ShadowFox88/keyboard/README.md

# Keyboard

This is a repo with the files used to make my own mechanical keyboard.

Why? It seemed like a fun project to do.

A journal of the time spent is available at report/report.pdf.

I used KiCad, and Fusion360 for this, and had to learn both of them.
All images are in the report.
