ShadowFox88/keyboard/images/keys.png

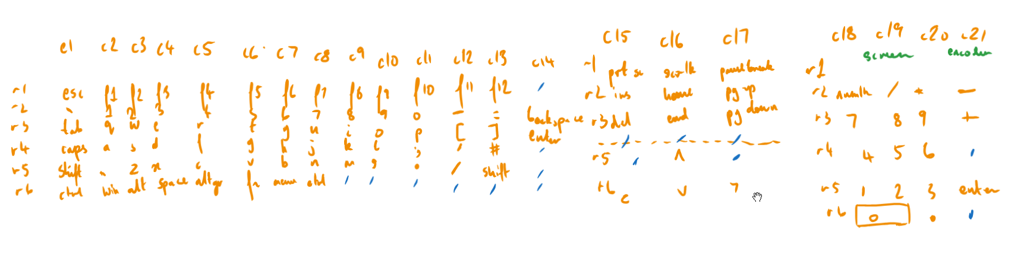
images/keys.png
