ShadowFox88/keyboard/images/keys_schematic.png

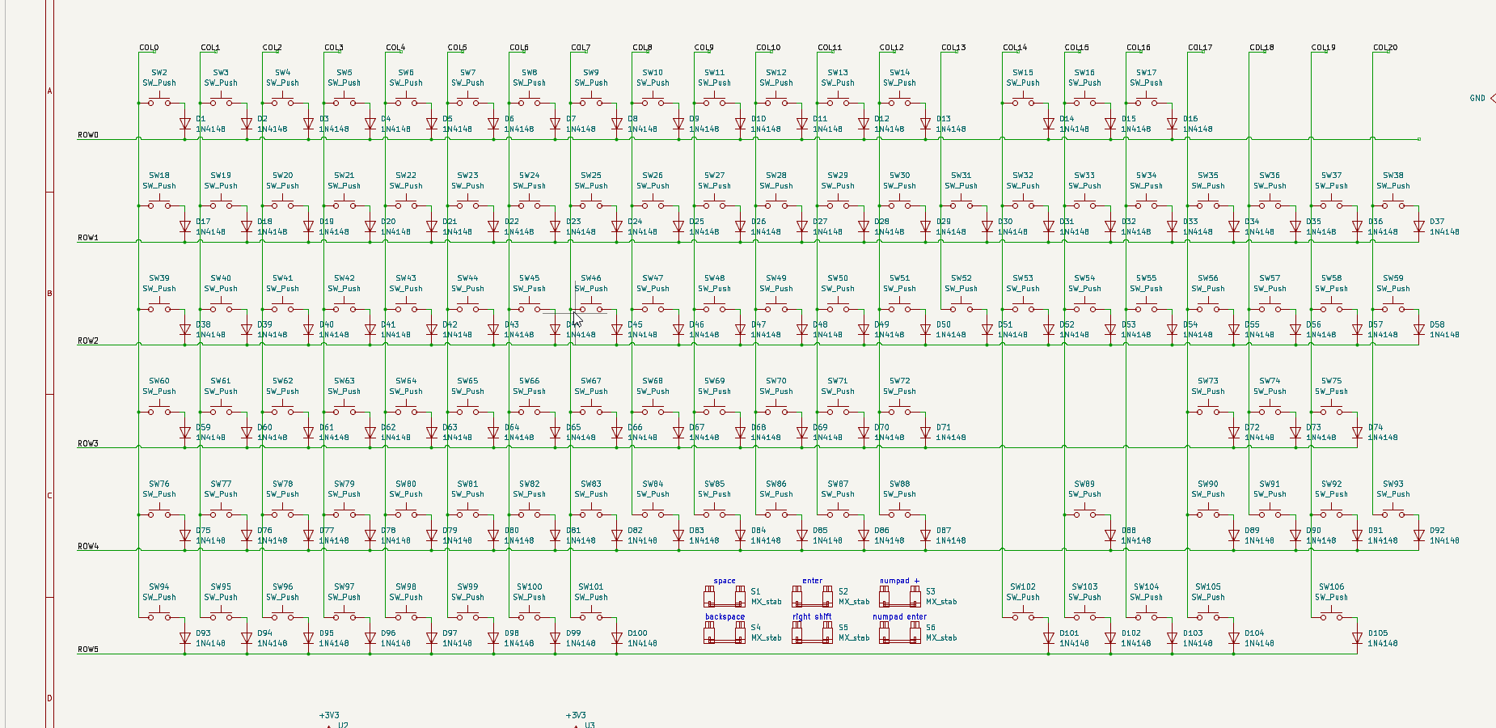
images/keys_schematic.png
