ShadowFox88/keyboard/images/pcb.png

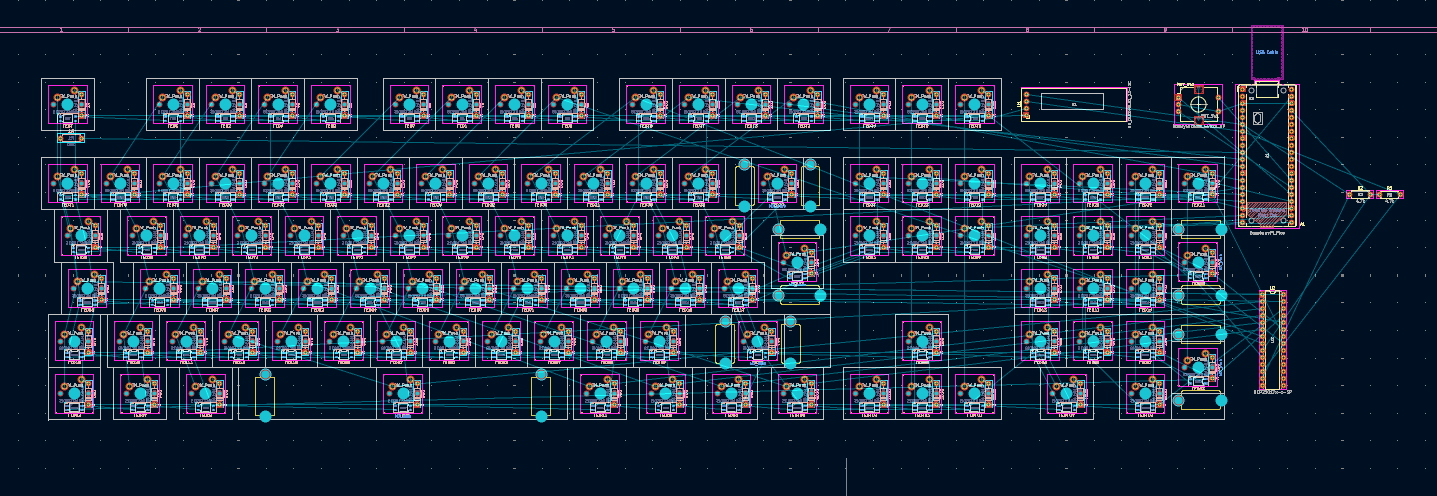
images/pcb.png
