ShadowFox88/keyboard/images/pcb_routing.png

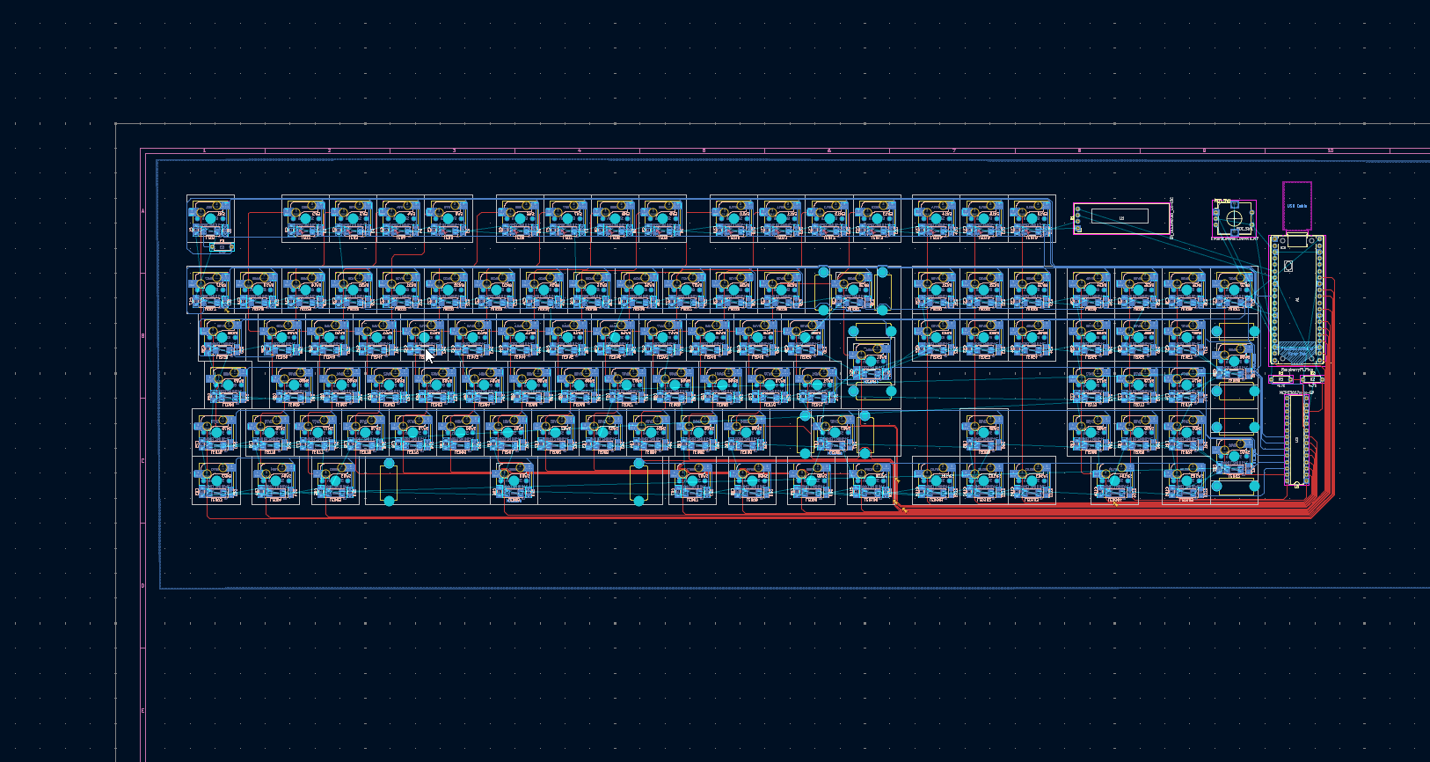
images/pcb_routing.png
