ShadowFox88/keyboard/images/rotary_and_screen.png

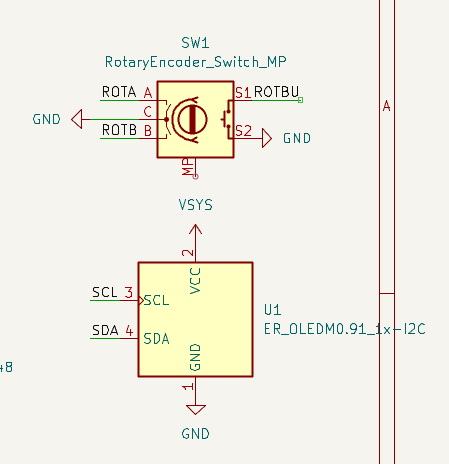
images/rotary_and_screen.png
