ShadowFox88/keyboard/pcb/pcb_v2.step

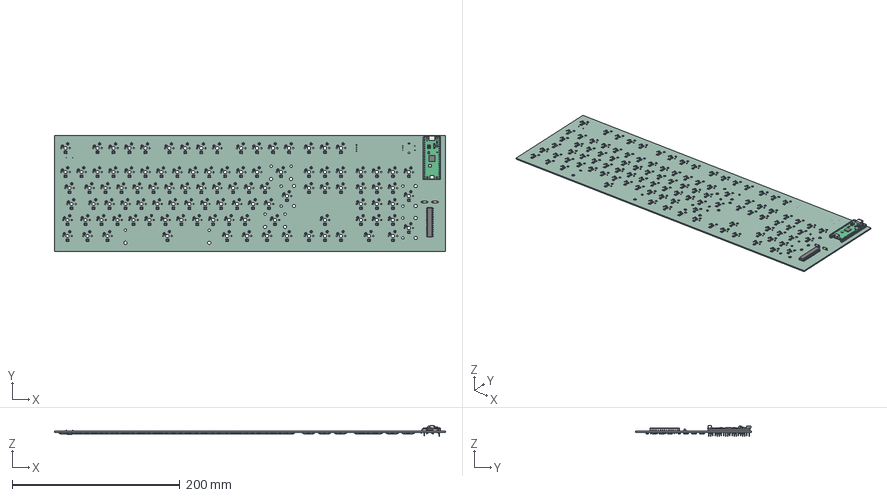
[picture p19: CAD file, 2026-08-04]
pcb/pcb_v2.step
466.6 x 138.7 x 12.8 mm
DIP-28_W7.62mm
R_Axial_DIN0207_L63mm_D25mm_P762mm_Horizontal x 3
RaspberryPi_Pico_H_Module_KiCad
RaspberryPi_Pico_Header_DIP-40_H2.54mm_KiCad
D_SOD_123F x 105
Pin1 x 105
Pin2 x 105
Pin3 x 105
Pin4 x 105
C_1206_3216Metric x 105
Contact x 210
keeb_PCB
