ShadowFox88/keyboard/(list of files, cad)

Other CAD files:
pcb/pcb.step
