ShadowFox88/keyboard/keeb.kicad_pcb

## KiCad design keeb.kicad_pcb (2026-08-04)

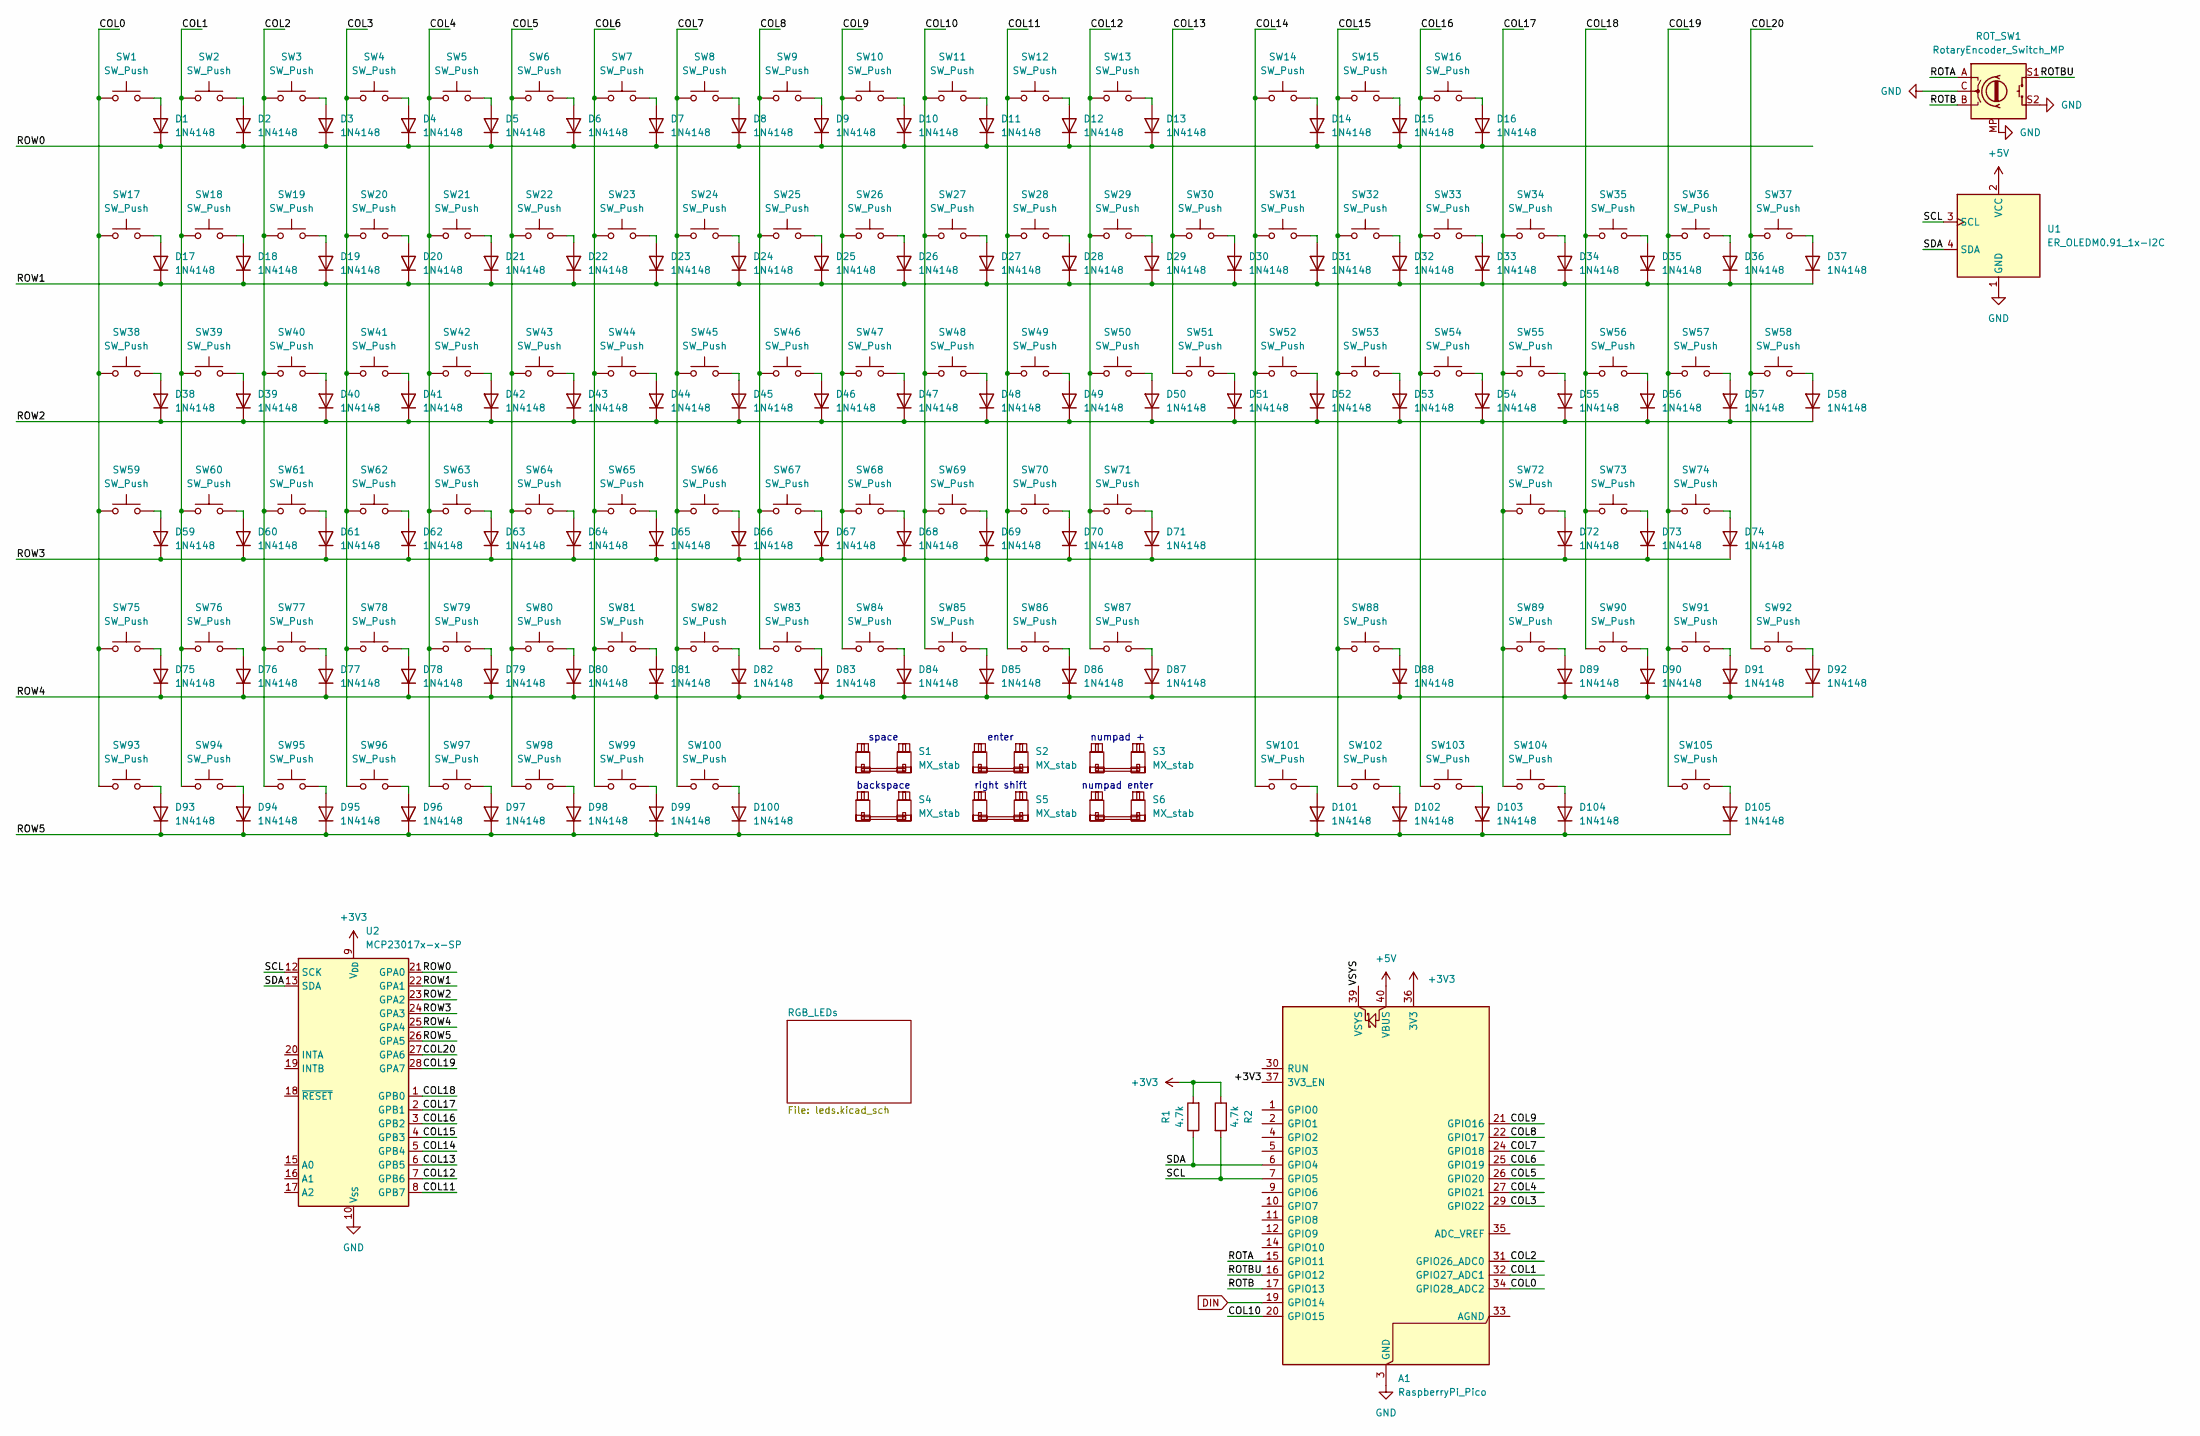
[picture p20: schematic keeb.kicad_sch]

Parts:
A1: RaspberryPi_Pico; RaspberryPi_Pico_Common_THT
D1, D2, D3, D4, D5, D6, D7, D8, D9, D10, D11, D12, D13, D14, D15, D16, D17, D18, D19, D20, D21, D22, D23, D24, D25, D26, D27, D28, D29, D30, D31, D32, D33, D34, D35, D36, D37, D38, D39, D40, D41, D42, D43, D44, D45, D46, D47, D48, D49, D50, D51, D52, D53, D54, D55, D56, D57, D58, D59, D60, D61, D62, D63, D64, D65, D66, D67, D68, D69, D70, D71, D72, D73, D74, D75, D76, D77, D78, D79, D80, D81, D82, D83, D84, D85, D86, D87, D88, D89, D90, D91, D92, D93, D94, D95, D96, D97, D98, D99, D100, D101, D102, D103, D104, D105: 1N4148; D_SOD-123F
R1, R2: 4.7k; R_Axial_DIN0207_L6.3mm_D2.5mm_P7.62mm_Horizontal
ROT_SW1: RotaryEncoder_Switch_MP; RotaryEncoder_Alps_EC11E-Switch_Vertical_H20mm
S1: MX_stab; STAB_MX_6.25u
S2: MX_stab; STAB_MX_ISO
S3, S4, S6: MX_stab; STAB_MX_2u
S5: MX_stab; STAB_MX_2.75u
SW1, SW2, SW3, SW4, SW5, SW6, SW7, SW8, SW9, SW10, SW11, SW12, SW13, SW14, SW15, SW16, SW17, SW18, SW19, SW20, SW21, SW22, SW23, SW24, SW25, SW26, SW27, SW28, SW29, SW30, SW31, SW32, SW33, SW34, SW35, SW36, SW37, SW38, SW39, SW40, SW41, SW42, SW43, SW44, SW45, SW46, SW47, SW48, SW49, SW50, SW51, SW52, SW53, SW54, SW55, SW56, SW57, SW58, SW59, SW60, SW61, SW62, SW63, SW64, SW65, SW66, SW67, SW68, SW69, SW70, SW71, SW72, SW73, SW74, SW75, SW76, SW77, SW78, SW79, SW80, SW81, SW82, SW83, SW84, SW85, SW86, SW87, SW88, SW89, SW90, SW91, SW92, SW93, SW94, SW95, SW96, SW97, SW98, SW99, SW100, SW101, SW102, SW103, SW104, SW105: SW_Push; SW_MX_HS_CPG151101S11_1u
U1: ER_OLEDM0.91_1x-I2C
U2: MCP23017x-x-SP; DIP-28_W7.62mm

Connections:
+3V3: A1.36 (3V3), A1.37 (3V3_EN), R1.2, R2.1, U2.9 (V_{DD})
+5V: A1.40 (VBUS), U1.2 (VCC); also elsewhere on the board
/COL0: A1.34 (GPIO28_ADC2), SW1.1, SW17.1, SW38.1, SW59.1, SW75.1, SW93.1
/COL1: A1.32 (GPIO27_ADC1), SW2.1, SW18.1, SW39.1, SW60.1, SW76.1, SW94.1
/COL2: A1.31 (GPIO26_ADC0), SW3.1, SW19.1, SW40.1, SW61.1, SW77.1, SW95.1
/COL3: A1.29 (GPIO22), SW4.1, SW20.1, SW41.1, SW62.1, SW78.1, SW96.1
/COL4: A1.27 (GPIO21), SW5.1, SW21.1, SW42.1, SW63.1, SW79.1, SW97.1
/COL5: A1.26 (GPIO20), SW6.1, SW22.1, SW43.1, SW64.1, SW80.1, SW98.1
/COL6: A1.25 (GPIO19), SW7.1, SW23.1, SW44.1, SW65.1, SW81.1, SW99.1
/COL7: A1.24 (GPIO18), SW8.1, SW24.1, SW45.1, SW66.1, SW82.1, SW100.1
/COL8: A1.22 (GPIO17), SW9.1, SW25.1, SW46.1, SW67.1, SW83.1
/COL9: A1.21 (GPIO16), SW10.1, SW26.1, SW47.1, SW68.1, SW84.1
/COL10: A1.20 (GPIO15), SW11.1, SW27.1, SW48.1, SW69.1, SW85.1
/COL11: SW12.1, SW28.1, SW49.1, SW70.1, SW86.1, U2.8 (GPB7)
/COL12: SW13.1, SW29.1, SW50.1, SW71.1, SW87.1, U2.7 (GPB6)
/COL13: SW30.1, SW51.1, U2.6 (GPB5)
/COL14: SW14.1, SW31.1, SW52.1, SW101.1, U2.5 (GPB4)
/COL15: SW15.1, SW32.1, SW53.1, SW88.1, SW102.1, U2.4 (GPB3)
/COL16: SW16.1, SW33.1, SW54.1, SW103.1, U2.3 (GPB2)
/COL17: SW34.1, SW55.1, SW72.1, SW89.1, SW104.1, U2.2 (GPB1)
/COL18: SW35.1, SW56.1, SW73.1, SW90.1, U2.1 (GPB0)
/COL19: SW36.1, SW57.1, SW74.1, SW91.1, SW105.1, U2.28 (GPA7)
/COL20: SW37.1, SW58.1, SW92.1, U2.27 (GPA6)
/ROTA: A1.15 (GPIO11), ROT_SW1.A
/ROTB: A1.17 (GPIO13), ROT_SW1.B
/ROTBU: A1.16 (GPIO12), ROT_SW1.S1
/ROW0: D1.1 (K), D2.1 (K), D3.1 (K), D4.1 (K), D5.1 (K), D6.1 (K), D7.1 (K), D8.1 (K), D9.1 (K), D10.1 (K), D11.1 (K), D12.1 (K), D13.1 (K), D14.1 (K), D15.1 (K), D16.1 (K), U2.21 (GPA0)
/ROW1: D17.1 (K), D18.1 (K), D19.1 (K), D20.1 (K), D21.1 (K), D22.1 (K), D23.1 (K), D24.1 (K), D25.1 (K), D26.1 (K), D27.1 (K), D28.1 (K), D29.1 (K), D30.1 (K), D31.1 (K), D32.1 (K), D33.1 (K), D34.1 (K), D35.1 (K), D36.1 (K), D37.1 (K), U2.22 (GPA1)
/ROW2: D38.1 (K), D39.1 (K), D40.1 (K), D41.1 (K), D42.1 (K), D43.1 (K), D44.1 (K), D45.1 (K), D46.1 (K), D47.1 (K), D48.1 (K), D49.1 (K), D50.1 (K), D51.1 (K), D52.1 (K), D53.1 (K), D54.1 (K), D55.1 (K), D56.1 (K), D57.1 (K), D58.1 (K), U2.23 (GPA2)
/ROW3: D59.1 (K), D60.1 (K), D61.1 (K), D62.1 (K), D63.1 (K), D64.1 (K), D65.1 (K), D66.1 (K), D67.1 (K), D68.1 (K), D69.1 (K), D70.1 (K), D71.1 (K), D72.1 (K), D73.1 (K), D74.1 (K), U2.24 (GPA3)
/ROW4: D75.1 (K), D76.1 (K), D77.1 (K), D78.1 (K), D79.1 (K), D80.1 (K), D81.1 (K), D82.1 (K), D83.1 (K), D84.1 (K), D85.1 (K), D86.1 (K), D87.1 (K), D88.1 (K), D89.1 (K), D90.1 (K), D91.1 (K), D92.1 (K), U2.25 (GPA4)
/ROW5: D93.1 (K), D94.1 (K), D95.1 (K), D96.1 (K), D97.1 (K), D98.1 (K), D99.1 (K), D100.1 (K), D101.1 (K), D102.1 (K), D103.1 (K), D104.1 (K), D105.1 (K), U2.26 (GPA5)
/SCL: A1.7 (GPIO5), R2.2, U1.3 (SCL), U2.12 (SCK)
/SDA: A1.6 (GPIO4), R1.1, U1.4 (SDA), U2.13 (SDA)
/VSYS: A1.39 (VSYS)
DIN: A1.19 (GPIO14); also elsewhere on the board
GND: A1.3 (GND), A1.8 (GND), A1.13 (GND), A1.18 (GND), A1.23 (GND), A1.28 (GND), A1.38 (GND), ROT_SW1.C, ROT_SW1.MP, ROT_SW1.S2, U1.1 (GND), U2.10 (V_{SS}); also elsewhere on the board
unnamed: D1.2 (A), SW1.2
unnamed: D2.2 (A), SW2.2
unnamed: D3.2 (A), SW3.2
unnamed: D4.2 (A), SW4.2
unnamed: D5.2 (A), SW5.2
unnamed: D6.2 (A), SW6.2
unnamed: D7.2 (A), SW7.2
unnamed: D8.2 (A), SW8.2
unnamed: D9.2 (A), SW9.2
unnamed: D10.2 (A), SW10.2
unnamed: D11.2 (A), SW11.2
unnamed: D12.2 (A), SW12.2
unnamed: D13.2 (A), SW13.2
unnamed: D14.2 (A), SW14.2
unnamed: D15.2 (A), SW15.2
unnamed: D16.2 (A), SW16.2
unnamed: D17.2 (A), SW17.2
unnamed: D18.2 (A), SW18.2
unnamed: D19.2 (A), SW19.2
unnamed: D20.2 (A), SW20.2
unnamed: D21.2 (A), SW21.2
unnamed: D22.2 (A), SW22.2
unnamed: D23.2 (A), SW23.2
unnamed: D24.2 (A), SW24.2
unnamed: D25.2 (A), SW25.2
unnamed: D26.2 (A), SW26.2
unnamed: D27.2 (A), SW27.2
unnamed: D28.2 (A), SW28.2
unnamed: D29.2 (A), SW29.2
unnamed: D30.2 (A), SW30.2
unnamed: D31.2 (A), SW31.2
unnamed: D32.2 (A), SW32.2
unnamed: D33.2 (A), SW33.2
unnamed: D34.2 (A), SW34.2
unnamed: D35.2 (A), SW35.2
unnamed: D36.2 (A), SW36.2
unnamed: D37.2 (A), SW37.2
unnamed: D38.2 (A), SW38.2
unnamed: D39.2 (A), SW39.2
unnamed: D40.2 (A), SW40.2
unnamed: D41.2 (A), SW41.2
unnamed: D42.2 (A), SW42.2
unnamed: D43.2 (A), SW43.2
unnamed: D44.2 (A), SW44.2
unnamed: D45.2 (A), SW45.2
unnamed: D46.2 (A), SW46.2
unnamed: D47.2 (A), SW47.2
unnamed: D48.2 (A), SW48.2
unnamed: D49.2 (A), SW49.2
unnamed: D50.2 (A), SW50.2
unnamed: D51.2 (A), SW51.2
unnamed: D52.2 (A), SW52.2
unnamed: D53.2 (A), SW53.2
unnamed: D54.2 (A), SW54.2
unnamed: D55.2 (A), SW55.2
unnamed: D56.2 (A), SW56.2
unnamed: D57.2 (A), SW57.2
unnamed: D58.2 (A), SW58.2
unnamed: D59.2 (A), SW59.2
unnamed: D60.2 (A), SW60.2
unnamed: D61.2 (A), SW61.2
unnamed: D62.2 (A), SW62.2
unnamed: D63.2 (A), SW63.2
unnamed: D64.2 (A), SW64.2
unnamed: D65.2 (A), SW65.2
unnamed: D66.2 (A), SW66.2
unnamed: D67.2 (A), SW67.2
unnamed: D68.2 (A), SW68.2
unnamed: D69.2 (A), SW69.2
unnamed: D70.2 (A), SW70.2
unnamed: D71.2 (A), SW71.2
unnamed: D72.2 (A), SW72.2
unnamed: D73.2 (A), SW73.2
unnamed: D74.2 (A), SW74.2
unnamed: D75.2 (A), SW75.2
unnamed: D76.2 (A), SW76.2
unnamed: D77.2 (A), SW77.2
unnamed: D78.2 (A), SW78.2
unnamed: D79.2 (A), SW79.2
unnamed: D80.2 (A), SW80.2
unnamed: D81.2 (A), SW81.2
unnamed: D82.2 (A), SW82.2
unnamed: D83.2 (A), SW83.2
unnamed: D84.2 (A), SW84.2
unnamed: D85.2 (A), SW85.2
unnamed: D86.2 (A), SW86.2
unnamed: D87.2 (A), SW87.2
unnamed: D88.2 (A), SW88.2
unnamed: D89.2 (A), SW89.2
unnamed: D90.2 (A), SW90.2
unnamed: D91.2 (A), SW91.2
unnamed: D92.2 (A), SW92.2
unnamed: D93.2 (A), SW93.2
unnamed: D94.2 (A), SW94.2
unnamed: D95.2 (A), SW95.2
unnamed: D96.2 (A), SW96.2
unnamed: D97.2 (A), SW97.2
unnamed: D98.2 (A), SW98.2
unnamed: D99.2 (A), SW99.2
unnamed: D100.2 (A), SW100.2
unnamed: D101.2 (A), SW101.2
unnamed: D102.2 (A), SW102.2
unnamed: D103.2 (A), SW103.2
unnamed: D104.2 (A), SW104.2
unnamed: D105.2 (A), SW105.2

Notes on the sheet:
numpad enter
numpad +
space
right shift
backspace
enter

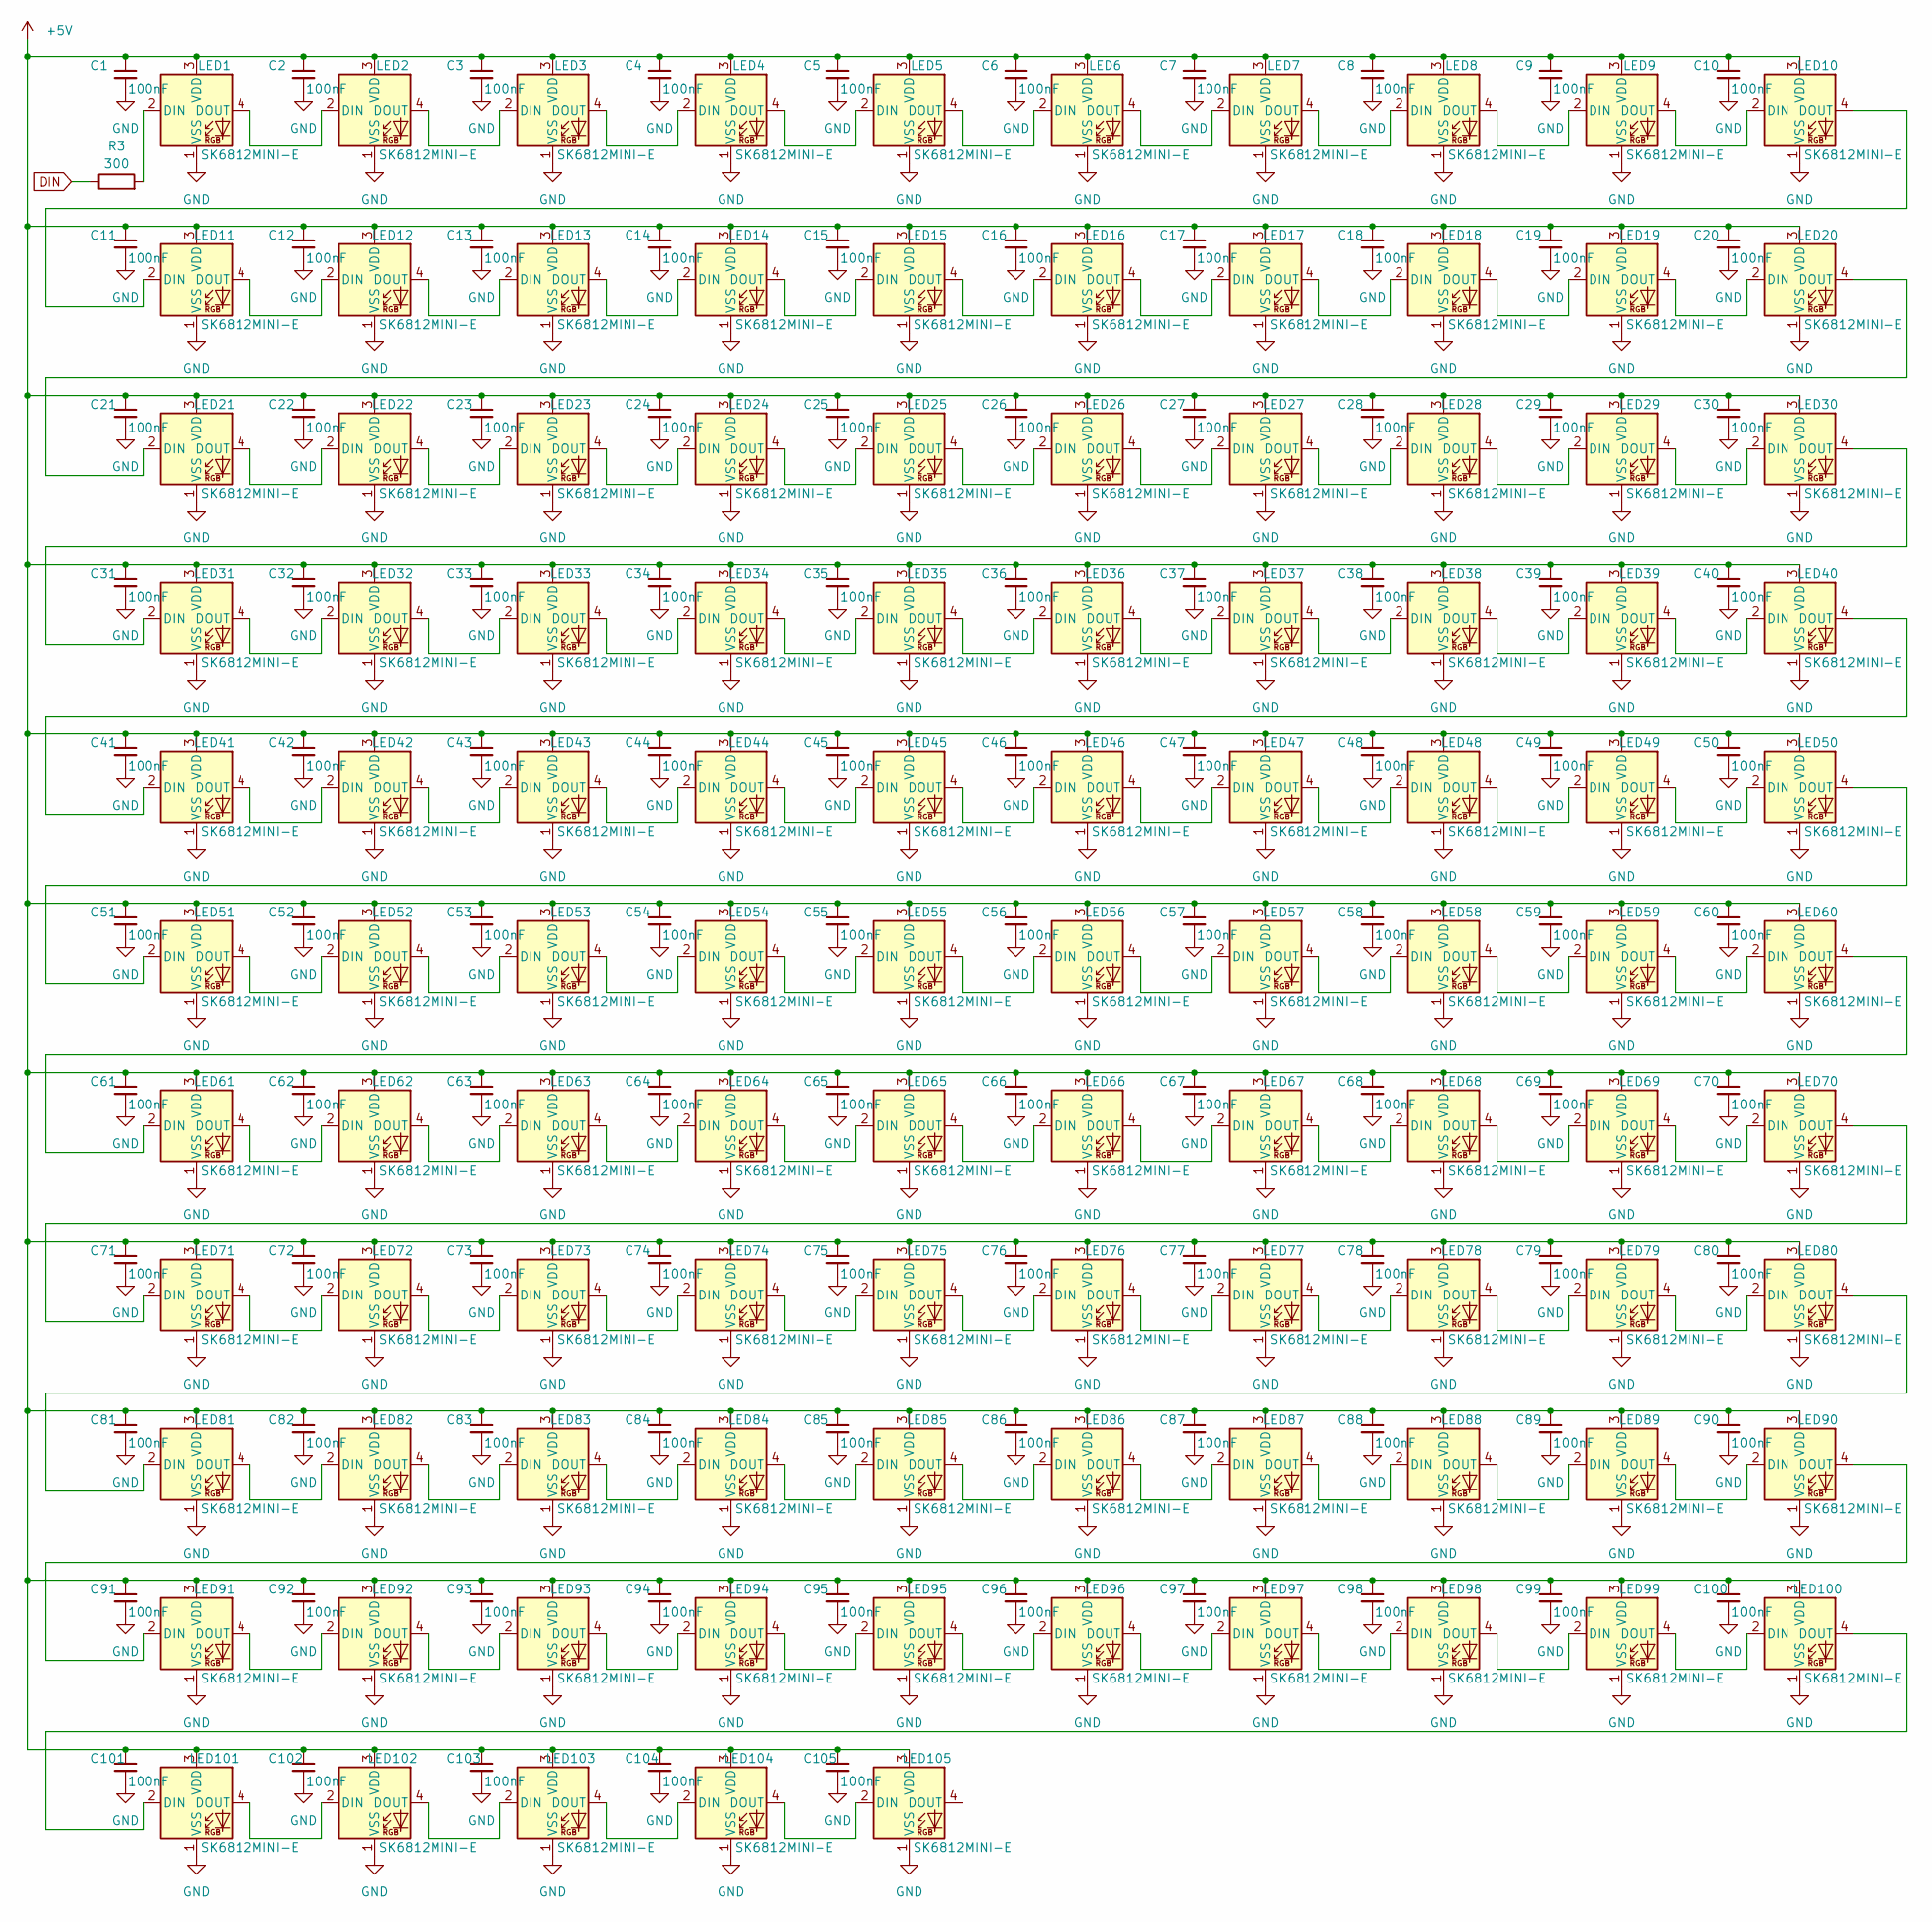
[picture p21: schematic leds.kicad_sch]

Parts:
C1, C2, C3, C4, C5, C6, C7, C8, C9, C10, C11, C12, C13, C14, C15, C16, C17, C18, C19, C20, C21, C22, C23, C24, C25, C26, C27, C28, C29, C30, C31, C32, C33, C34, C35, C36, C37, C38, C39, C40, C41, C42, C43, C44, C45, C46, C47, C48, C49, C50, C51, C52, C53, C54, C55, C56, C57, C58, C59, C60, C61, C62, C63, C64, C65, C66, C67, C68, C69, C70, C71, C72, C73, C74, C75, C76, C77, C78, C79, C80, C81, C82, C83, C84, C85, C86, C87, C88, C89, C90, C91, C92, C93, C94, C95, C96, C97, C98, C99, C100, C101, C102, C103, C104, C105: 100nF; C_1206_3216Metric_Pad1.33x1.80mm_HandSolder
LED1, LED2, LED3, LED4, LED5, LED6, LED7, LED8, LED9, LED10, LED11, LED12, LED13, LED14, LED15, LED16, LED17, LED18, LED19, LED20, LED21, LED22, LED23, LED24, LED25, LED26, LED27, LED28, LED29, LED30, LED31, LED32, LED33, LED34, LED35, LED36, LED37, LED38, LED39, LED40, LED41, LED42, LED43, LED44, LED45, LED46, LED47, LED48, LED49, LED50, LED51, LED52, LED53, LED54, LED55, LED56, LED57, LED58, LED59, LED60, LED61, LED62, LED63, LED64, LED65, LED66, LED67, LED68, LED69, LED70, LED71, LED72, LED73, LED74, LED75, LED76, LED77, LED78, LED79, LED80, LED81, LED82, LED83, LED84, LED85, LED86, LED87, LED88, LED89, LED90, LED91, LED92, LED93, LED94, LED95, LED96, LED97, LED98, LED99, LED100, LED101, LED102, LED103, LED104, LED105: SK6812MINI-E; LED_SK6812MINI-E_3.2x2.8mm_P1.5mm_ReverseMount
R3: 300; R_Axial_DIN0207_L6.3mm_D2.5mm_P7.62mm_Horizontal

Connections:
+5V: C1.1, C2.1, C3.1, C4.1, C5.1, C6.1, C7.1, C8.1, C9.1, C10.1, C11.1, C12.1, C13.1, C14.1, C15.1, C16.1, C17.1, C18.1, C19.1, C20.1, C21.1, C22.1, C23.1, C24.1, C25.1, C26.1, C27.1, C28.1, C29.1, C30.1, C31.1, C32.1, C33.1, C34.1, C35.1, C36.1, C37.1, C38.1, C39.1, C40.1, C41.1, C42.1, C43.1, C44.1, C45.1, C46.1, C47.1, C48.1, C49.1, C50.1, C51.1, C52.1, C53.1, C54.1, C55.1, C56.1, C57.1, C58.1, C59.1, C60.1, C61.1, C62.1, C63.1, C64.1, C65.1, C66.1, C67.1, C68.1, C69.1, C70.1, C71.1, C72.1, C73.1, C74.1, C75.1, C76.1, C77.1, C78.1, C79.1, C80.1, C81.1, C82.1, C83.1, C84.1, C85.1, C86.1, C87.1, C88.1, C89.1, C90.1, C91.1, C92.1, C93.1, C94.1, C95.1, C96.1, C97.1, C98.1, C99.1, C100.1, C101.1, C102.1, C103.1, C104.1, C105.1, LED1.3 (VDD), LED2.3 (VDD), LED3.3 (VDD), LED4.3 (VDD), LED5.3 (VDD), LED6.3 (VDD), LED7.3 (VDD), LED8.3 (VDD), LED9.3 (VDD), LED10.3 (VDD), LED11.3 (VDD), LED12.3 (VDD), LED13.3 (VDD), LED14.3 (VDD), LED15.3 (VDD), LED16.3 (VDD), LED17.3 (VDD), LED18.3 (VDD), LED19.3 (VDD), LED20.3 (VDD), LED21.3 (VDD), LED22.3 (VDD), LED23.3 (VDD), LED24.3 (VDD), LED25.3 (VDD), LED26.3 (VDD), LED27.3 (VDD), LED28.3 (VDD), LED29.3 (VDD), LED30.3 (VDD), LED31.3 (VDD), LED32.3 (VDD), LED33.3 (VDD), LED34.3 (VDD), LED35.3 (VDD), LED36.3 (VDD), LED37.3 (VDD), LED38.3 (VDD), LED39.3 (VDD), LED40.3 (VDD), LED41.3 (VDD), LED42.3 (VDD), LED43.3 (VDD), LED44.3 (VDD), LED45.3 (VDD), LED46.3 (VDD), LED47.3 (VDD), LED48.3 (VDD), LED49.3 (VDD), LED50.3 (VDD), LED51.3 (VDD), LED52.3 (VDD), LED53.3 (VDD), LED54.3 (VDD), LED55.3 (VDD), LED56.3 (VDD), LED57.3 (VDD), LED58.3 (VDD), LED59.3 (VDD), LED60.3 (VDD), LED61.3 (VDD), LED62.3 (VDD), LED63.3 (VDD), LED64.3 (VDD), LED65.3 (VDD), LED66.3 (VDD), LED67.3 (VDD), LED68.3 (VDD), LED69.3 (VDD), LED70.3 (VDD), LED71.3 (VDD), LED72.3 (VDD), LED73.3 (VDD), LED74.3 (VDD), LED75.3 (VDD), LED76.3 (VDD), LED77.3 (VDD), LED78.3 (VDD), LED79.3 (VDD), LED80.3 (VDD), LED81.3 (VDD), LED82.3 (VDD), LED83.3 (VDD), LED84.3 (VDD), LED85.3 (VDD), LED86.3 (VDD), LED87.3 (VDD), LED88.3 (VDD), LED89.3 (VDD), LED90.3 (VDD), LED91.3 (VDD), LED92.3 (VDD), LED93.3 (VDD), LED94.3 (VDD), LED95.3 (VDD), LED96.3 (VDD), LED97.3 (VDD), LED98.3 (VDD), LED99.3 (VDD), LED100.3 (VDD), LED101.3 (VDD), LED102.3 (VDD), LED103.3 (VDD), LED104.3 (VDD), LED105.3 (VDD); also elsewhere on the board
DIN: R3.1; also elsewhere on the board
GND: C1.2, C2.2, C3.2, C4.2, C5.2, C6.2, C7.2, C8.2, C9.2, C10.2, C11.2, C12.2, C13.2, C14.2, C15.2, C16.2, C17.2, C18.2, C19.2, C20.2, C21.2, C22.2, C23.2, C24.2, C25.2, C26.2, C27.2, C28.2, C29.2, C30.2, C31.2, C32.2, C33.2, C34.2, C35.2, C36.2, C37.2, C38.2, C39.2, C40.2, C41.2, C42.2, C43.2, C44.2, C45.2, C46.2, C47.2, C48.2, C49.2, C50.2, C51.2, C52.2, C53.2, C54.2, C55.2, C56.2, C57.2, C58.2, C59.2, C60.2, C61.2, C62.2, C63.2, C64.2, C65.2, C66.2, C67.2, C68.2, C69.2, C70.2, C71.2, C72.2, C73.2, C74.2, C75.2, C76.2, C77.2, C78.2, C79.2, C80.2, C81.2, C82.2, C83.2, C84.2, C85.2, C86.2, C87.2, C88.2, C89.2, C90.2, C91.2, C92.2, C93.2, C94.2, C95.2, C96.2, C97.2, C98.2, C99.2, C100.2, C101.2, C102.2, C103.2, C104.2, C105.2, LED1.1 (VSS), LED2.1 (VSS), LED3.1 (VSS), LED4.1 (VSS), LED5.1 (VSS), LED6.1 (VSS), LED7.1 (VSS), LED8.1 (VSS), LED9.1 (VSS), LED10.1 (VSS), LED11.1 (VSS), LED12.1 (VSS), LED13.1 (VSS), LED14.1 (VSS), LED15.1 (VSS), LED16.1 (VSS), LED17.1 (VSS), LED18.1 (VSS), LED19.1 (VSS), LED20.1 (VSS), LED21.1 (VSS), LED22.1 (VSS), LED23.1 (VSS), LED24.1 (VSS), LED25.1 (VSS), LED26.1 (VSS), LED27.1 (VSS), LED28.1 (VSS), LED29.1 (VSS), LED30.1 (VSS), LED31.1 (VSS), LED32.1 (VSS), LED33.1 (VSS), LED34.1 (VSS), LED35.1 (VSS), LED36.1 (VSS), LED37.1 (VSS), LED38.1 (VSS), LED39.1 (VSS), LED40.1 (VSS), LED41.1 (VSS), LED42.1 (VSS), LED43.1 (VSS), LED44.1 (VSS), LED45.1 (VSS), LED46.1 (VSS), LED47.1 (VSS), LED48.1 (VSS), LED49.1 (VSS), LED50.1 (VSS), LED51.1 (VSS), LED52.1 (VSS), LED53.1 (VSS), LED54.1 (VSS), LED55.1 (VSS), LED56.1 (VSS), LED57.1 (VSS), LED58.1 (VSS), LED59.1 (VSS), LED60.1 (VSS), LED61.1 (VSS), LED62.1 (VSS), LED63.1 (VSS), LED64.1 (VSS), LED65.1 (VSS), LED66.1 (VSS), LED67.1 (VSS), LED68.1 (VSS), LED69.1 (VSS), LED70.1 (VSS), LED71.1 (VSS), LED72.1 (VSS), LED73.1 (VSS), LED74.1 (VSS), LED75.1 (VSS), LED76.1 (VSS), LED77.1 (VSS), LED78.1 (VSS), LED79.1 (VSS), LED80.1 (VSS), LED81.1 (VSS), LED82.1 (VSS), LED83.1 (VSS), LED84.1 (VSS), LED85.1 (VSS), LED86.1 (VSS), LED87.1 (VSS), LED88.1 (VSS), LED89.1 (VSS), LED90.1 (VSS), LED91.1 (VSS), LED92.1 (VSS), LED93.1 (VSS), LED94.1 (VSS), LED95.1 (VSS), LED96.1 (VSS), LED97.1 (VSS), LED98.1 (VSS), LED99.1 (VSS), LED100.1 (VSS), LED101.1 (VSS), LED102.1 (VSS), LED103.1 (VSS), LED104.1 (VSS), LED105.1 (VSS); also elsewhere on the board
unnamed: LED1.2 (DIN), R3.2
unnamed: LED1.4 (DOUT), LED2.2 (DIN)
unnamed: LED2.4 (DOUT), LED3.2 (DIN)
unnamed: LED3.4 (DOUT), LED4.2 (DIN)
unnamed: LED4.4 (DOUT), LED5.2 (DIN)
unnamed: LED5.4 (DOUT), LED6.2 (DIN)
unnamed: LED6.4 (DOUT), LED7.2 (DIN)
unnamed: LED7.4 (DOUT), LED8.2 (DIN)
unnamed: LED8.4 (DOUT), LED9.2 (DIN)
unnamed: LED9.4 (DOUT), LED10.2 (DIN)
unnamed: LED10.4 (DOUT), LED11.2 (DIN)
unnamed: LED11.4 (DOUT), LED12.2 (DIN)
unnamed: LED12.4 (DOUT), LED13.2 (DIN)
unnamed: LED13.4 (DOUT), LED14.2 (DIN)
unnamed: LED14.4 (DOUT), LED15.2 (DIN)
unnamed: LED15.4 (DOUT), LED16.2 (DIN)
unnamed: LED16.4 (DOUT), LED17.2 (DIN)
unnamed: LED17.4 (DOUT), LED18.2 (DIN)
unnamed: LED18.4 (DOUT), LED19.2 (DIN)
unnamed: LED19.4 (DOUT), LED20.2 (DIN)
unnamed: LED20.4 (DOUT), LED21.2 (DIN)
unnamed: LED21.4 (DOUT), LED22.2 (DIN)
unnamed: LED22.4 (DOUT), LED23.2 (DIN)
unnamed: LED23.4 (DOUT), LED24.2 (DIN)
unnamed: LED24.4 (DOUT), LED25.2 (DIN)
unnamed: LED25.4 (DOUT), LED26.2 (DIN)
unnamed: LED26.4 (DOUT), LED27.2 (DIN)
unnamed: LED27.4 (DOUT), LED28.2 (DIN)
unnamed: LED28.4 (DOUT), LED29.2 (DIN)
unnamed: LED29.4 (DOUT), LED30.2 (DIN)
unnamed: LED30.4 (DOUT), LED31.2 (DIN)
unnamed: LED31.4 (DOUT), LED32.2 (DIN)
unnamed: LED32.4 (DOUT), LED33.2 (DIN)
unnamed: LED33.4 (DOUT), LED34.2 (DIN)
unnamed: LED34.4 (DOUT), LED35.2 (DIN)
unnamed: LED35.4 (DOUT), LED36.2 (DIN)
unnamed: LED36.4 (DOUT), LED37.2 (DIN)
unnamed: LED37.4 (DOUT), LED38.2 (DIN)
unnamed: LED38.4 (DOUT), LED39.2 (DIN)
unnamed: LED39.4 (DOUT), LED40.2 (DIN)
unnamed: LED40.4 (DOUT), LED41.2 (DIN)
unnamed: LED41.4 (DOUT), LED42.2 (DIN)
unnamed: LED42.4 (DOUT), LED43.2 (DIN)
unnamed: LED43.4 (DOUT), LED44.2 (DIN)
unnamed: LED44.4 (DOUT), LED45.2 (DIN)
unnamed: LED45.4 (DOUT), LED46.2 (DIN)
unnamed: LED46.4 (DOUT), LED47.2 (DIN)
unnamed: LED47.4 (DOUT), LED48.2 (DIN)
unnamed: LED48.4 (DOUT), LED49.2 (DIN)
unnamed: LED49.4 (DOUT), LED50.2 (DIN)
unnamed: LED50.4 (DOUT), LED51.2 (DIN)
unnamed: LED51.4 (DOUT), LED52.2 (DIN)
unnamed: LED52.4 (DOUT), LED53.2 (DIN)
unnamed: LED53.4 (DOUT), LED54.2 (DIN)
unnamed: LED54.4 (DOUT), LED55.2 (DIN)
unnamed: LED55.4 (DOUT), LED56.2 (DIN)
unnamed: LED56.4 (DOUT), LED57.2 (DIN)
unnamed: LED57.4 (DOUT), LED58.2 (DIN)
unnamed: LED58.4 (DOUT), LED59.2 (DIN)
unnamed: LED59.4 (DOUT), LED60.2 (DIN)
unnamed: LED60.4 (DOUT), LED61.2 (DIN)
unnamed: LED61.4 (DOUT), LED62.2 (DIN)
unnamed: LED62.4 (DOUT), LED63.2 (DIN)
unnamed: LED63.4 (DOUT), LED64.2 (DIN)
unnamed: LED64.4 (DOUT), LED65.2 (DIN)
unnamed: LED65.4 (DOUT), LED66.2 (DIN)
unnamed: LED66.4 (DOUT), LED67.2 (DIN)
unnamed: LED67.4 (DOUT), LED68.2 (DIN)
unnamed: LED68.4 (DOUT), LED69.2 (DIN)
unnamed: LED69.4 (DOUT), LED70.2 (DIN)
unnamed: LED70.4 (DOUT), LED71.2 (DIN)
unnamed: LED71.4 (DOUT), LED72.2 (DIN)
unnamed: LED72.4 (DOUT), LED73.2 (DIN)
unnamed: LED73.4 (DOUT), LED74.2 (DIN)
unnamed: LED74.4 (DOUT), LED75.2 (DIN)
unnamed: LED75.4 (DOUT), LED76.2 (DIN)
unnamed: LED76.4 (DOUT), LED77.2 (DIN)
unnamed: LED77.4 (DOUT), LED78.2 (DIN)
unnamed: LED78.4 (DOUT), LED79.2 (DIN)
unnamed: LED79.4 (DOUT), LED80.2 (DIN)
unnamed: LED80.4 (DOUT), LED81.2 (DIN)
unnamed: LED81.4 (DOUT), LED82.2 (DIN)
unnamed: LED82.4 (DOUT), LED83.2 (DIN)
unnamed: LED83.4 (DOUT), LED84.2 (DIN)
unnamed: LED84.4 (DOUT), LED85.2 (DIN)
unnamed: LED85.4 (DOUT), LED86.2 (DIN)
unnamed: LED86.4 (DOUT), LED87.2 (DIN)
unnamed: LED87.4 (DOUT), LED88.2 (DIN)
unnamed: LED88.4 (DOUT), LED89.2 (DIN)
unnamed: LED89.4 (DOUT), LED90.2 (DIN)
unnamed: LED90.4 (DOUT), LED91.2 (DIN)
unnamed: LED91.4 (DOUT), LED92.2 (DIN)
unnamed: LED92.4 (DOUT), LED93.2 (DIN)
unnamed: LED93.4 (DOUT), LED94.2 (DIN)
unnamed: LED94.4 (DOUT), LED95.2 (DIN)
unnamed: LED95.4 (DOUT), LED96.2 (DIN)
unnamed: LED96.4 (DOUT), LED97.2 (DIN)
unnamed: LED97.4 (DOUT), LED98.2 (DIN)
unnamed: LED98.4 (DOUT), LED99.2 (DIN)
unnamed: LED99.4 (DOUT), LED100.2 (DIN)
unnamed: LED100.4 (DOUT), LED101.2 (DIN)
unnamed: LED101.4 (DOUT), LED102.2 (DIN)
unnamed: LED102.4 (DOUT), LED103.2 (DIN)
unnamed: LED103.4 (DOUT), LED104.2 (DIN)
unnamed: LED104.4 (DOUT), LED105.2 (DIN)

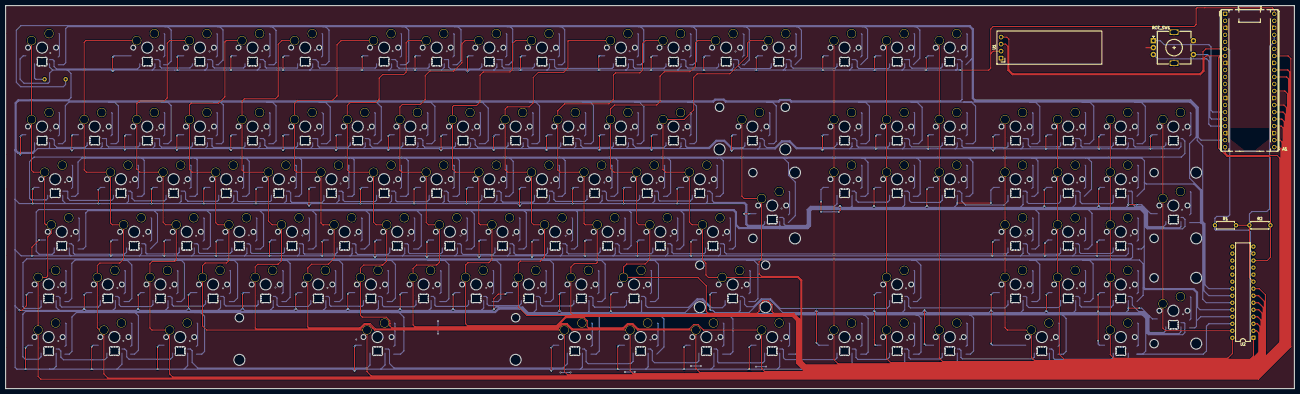
[picture p22: board keeb.kicad_pcb from above]

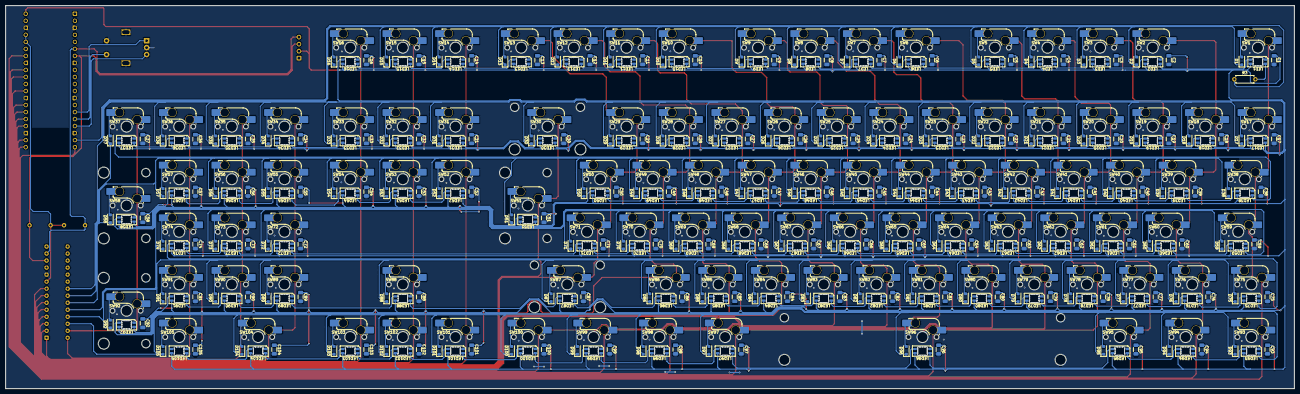
[picture p23: board keeb.kicad_pcb from below]

Board: 2 copper layers, 466.6 x 138.7 mm, 433 parts (421 on the bottom side), 246 nets.
