ShadowFox88/keyboard/(commit log)

2026-07-21 started kicad
    [keeb.kicad_pcb, keeb.kicad_sch]
2026-07-21 started report and did some intial design
    [keeb.kicad_sch]
2026-07-22 did some work on schematics
    [keeb.kicad_sch]
2026-07-22 been 4 hours of CHANGING EVERYTHING AAAAAAAAAAAAAAAAAAAAAAAAAAAA
    [keeb.kicad_pcb]
2026-07-22 did more work on traces and added capacitors and hotswappable switches
    [keeb.kicad_sch, leds.kicad_sch]
2026-07-22 more journalling
    [keeb.kicad_sch, leds.kicad_sch]
2026-07-23 did more work and journaling
    [keeb.kicad_pcb, keeb.kicad_sch, leds.kicad_sch]
2026-07-23 moved traces
2026-07-23 did more routing
    [keeb.kicad_pcb, keeb.kicad_sch, leds.kicad_sch]
2026-07-23 PCB DESIGN DONE!!!!
    [keeb.kicad_sch, leds.kicad_sch]
2026-07-24 i hate fusion
    [.step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]
2026-08-04 IM FREEEE
    [keeb-B_Cu.gbr, keeb-B_Mask.gbr, keeb-B_Paste.gbr, keeb-B_Silkscreen.gbr, keeb-Edge_Cuts.gbr, keeb-F_Cu.gbr, keeb-F_Mask.gbr, keeb-F_Paste.gbr]
2026-08-04 did stuff
    [.step, bom.csv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]
